emanuelvsz/localfy/hardware/case/stl/frente.stl

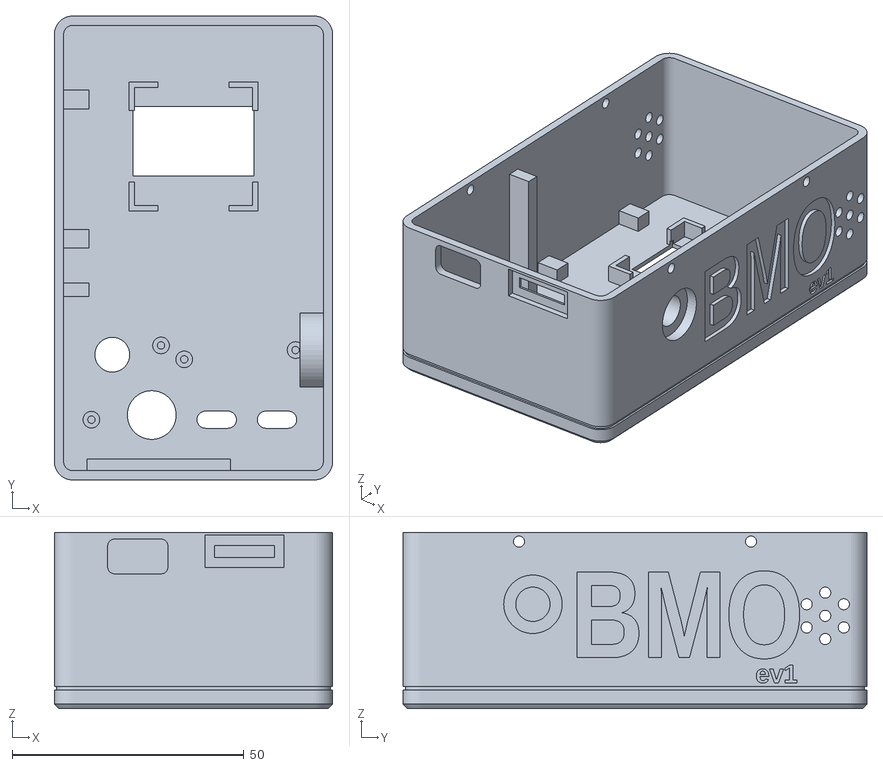
[picture p1: CAD file, 2026-10-16]
hardware/case/stl/frente.stl
60.0 x 100.0 x 38.0
