emanuelvsz/localfy/hardware/case/stl/teste_suporte.stl

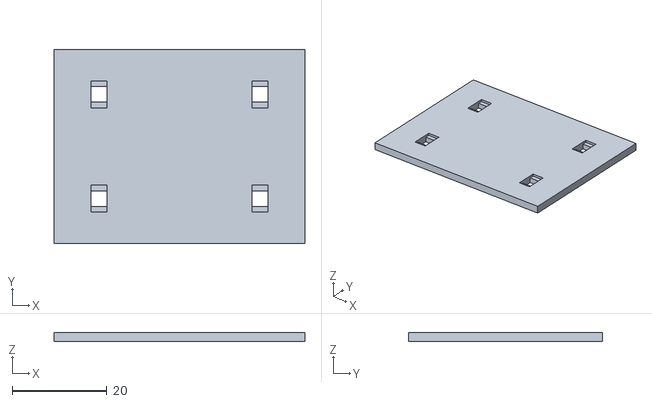
[picture p2: CAD file, 2026-10-16]
hardware/case/stl/teste_suporte.stl
53.0 x 41.0 x 2.00
