emanuelvsz/localfy/hardware/case/stl/base.stl

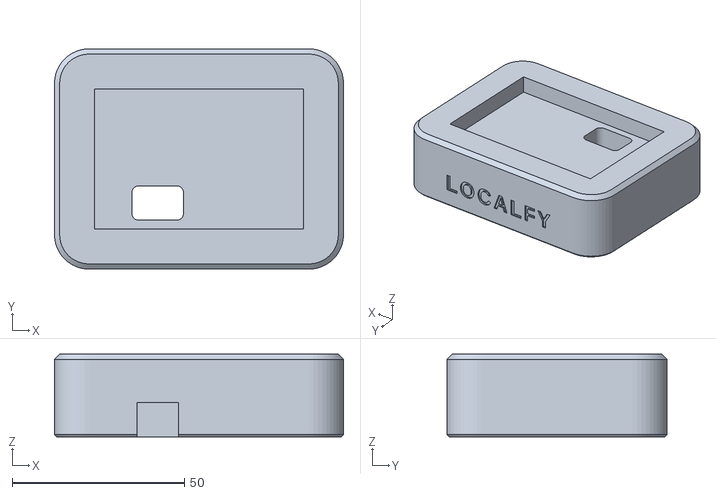
[picture p3: CAD file, 2026-10-16]
hardware/case/stl/base.stl
84.0 x 64.0 x 24.0
