emanuelvsz/localfy/hardware/case/stl/tampa.stl

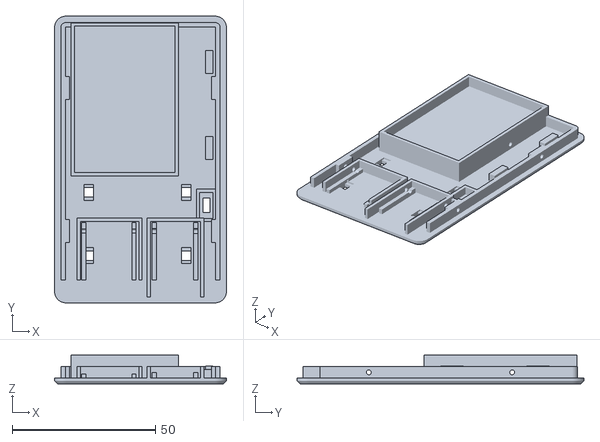
[picture p4: CAD file, 2026-10-16]
hardware/case/stl/tampa.stl
60.0 x 100.0 x 10.0
