emanuelvsz/localfy/hardware/case/stl/moldura.stl

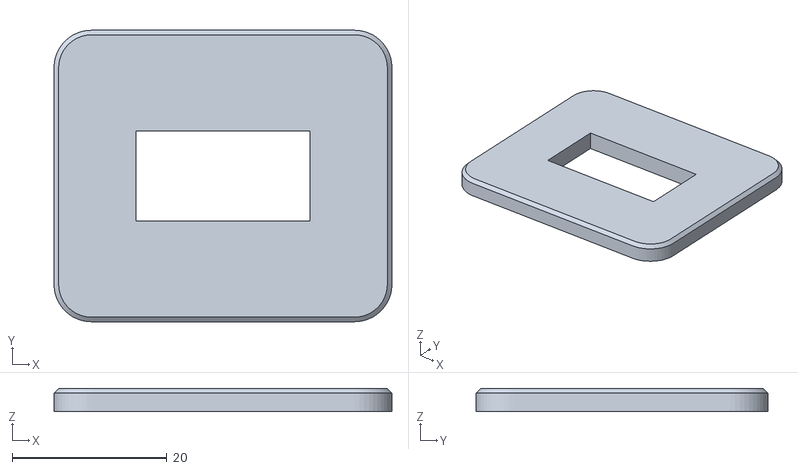
[picture p5: CAD file, 2026-10-05]
hardware/case/stl/moldura.stl
43.7 x 37.7 x 3.00
