emanuelvsz/localfy/hardware/case/stl/bolinha.stl

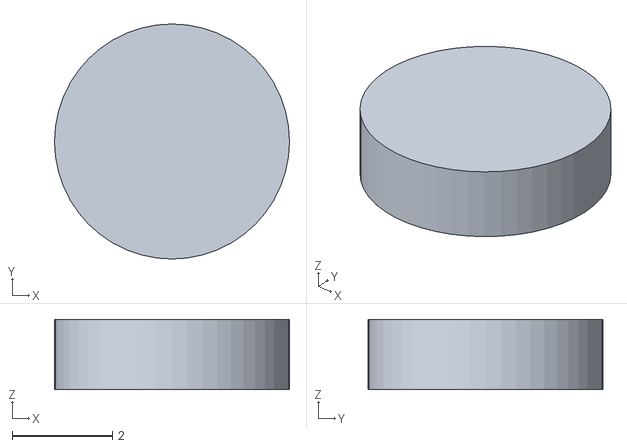
[picture p6: CAD file, 2026-10-05]
hardware/case/stl/bolinha.stl
4.70 x 4.70 x 1.40
