emanuelvsz/localfy/hardware/case/stl/cruz.stl

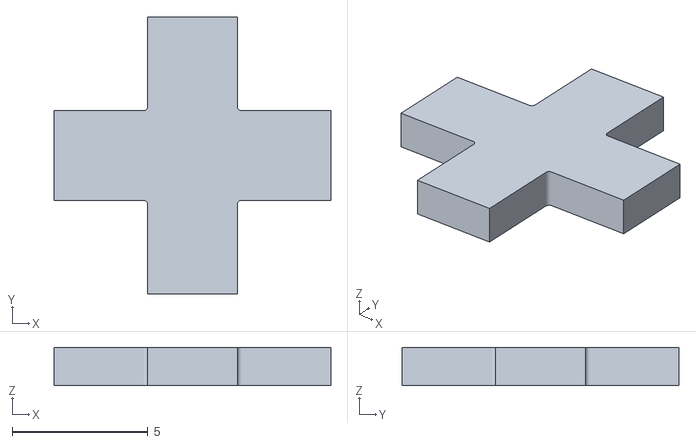
[picture p7: CAD file, 2026-10-05]
hardware/case/stl/cruz.stl
10.2 x 10.2 x 1.40
