emanuelvsz/localfy/hardware/case/stl/vermelho.stl

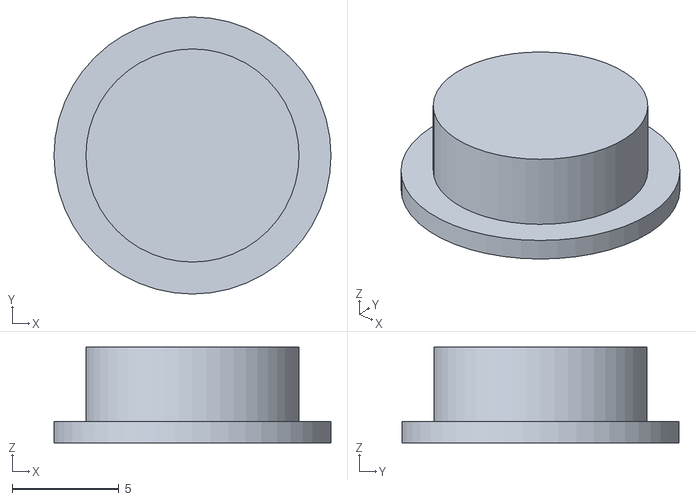
[picture p8: CAD file, 2026-10-05]
hardware/case/stl/vermelho.stl
13.0 x 13.0 x 4.50
