emanuelvsz/localfy/hardware/case/stl/fenda.stl

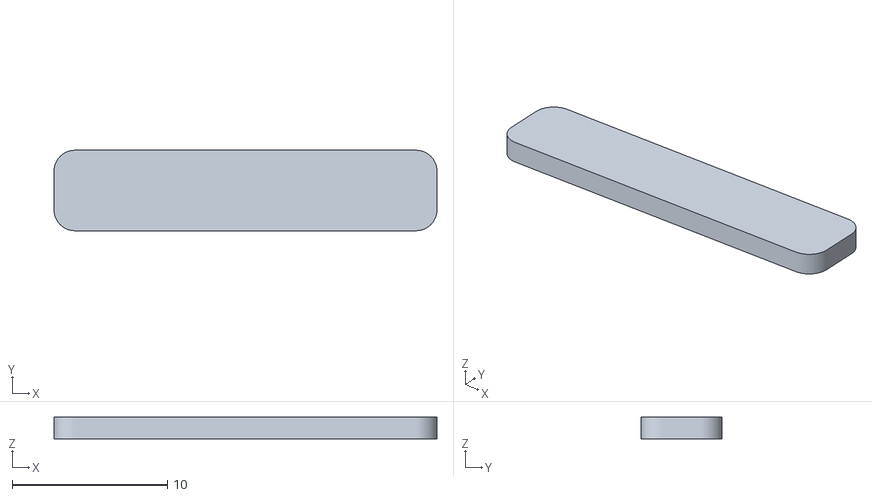
[picture p9: CAD file, 2026-10-05]
hardware/case/stl/fenda.stl
24.7 x 5.20 x 1.40
