emanuelvsz/localfy/hardware/case/stl/triangulo.stl

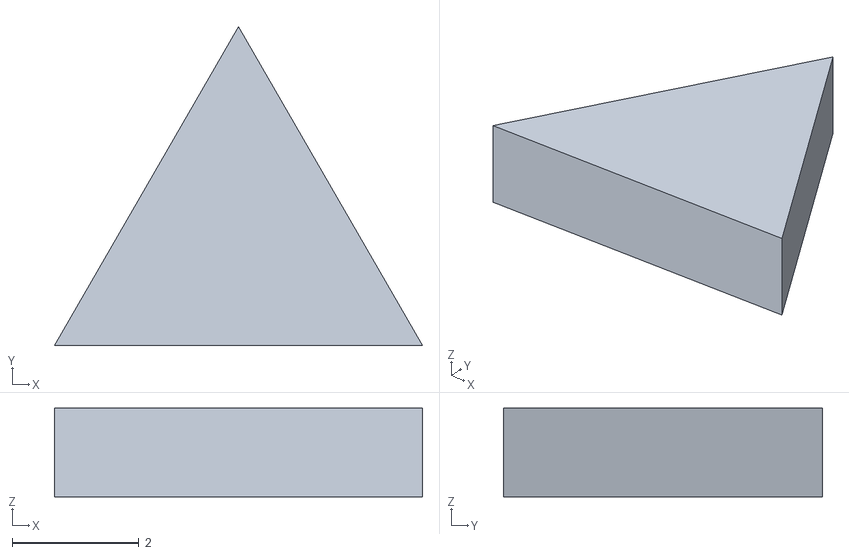
[picture p10: CAD file, 2026-10-05]
hardware/case/stl/triangulo.stl
5.81 x 5.03 x 1.40
