emanuelvsz/localfy/hardware/case/stl/verde.stl

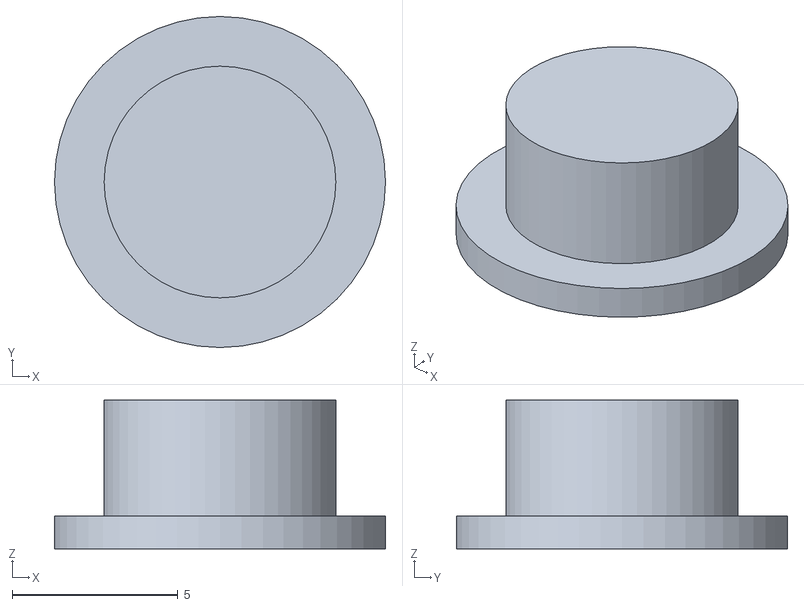
[picture p11: CAD file, 2026-10-05]
hardware/case/stl/verde.stl
10.0 x 10.0 x 4.50
