emanuelvsz/localfy/hardware/case/stl/letras.stl

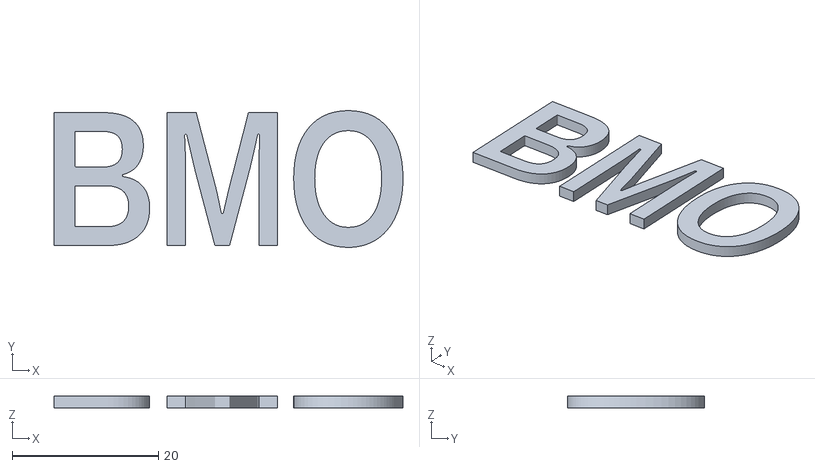
[picture p12: CAD file, 2026-10-05]
hardware/case/stl/letras.stl
47.7 x 18.7 x 1.60
