emanuelvsz/localfy/hardware/case/stl/knob.stl

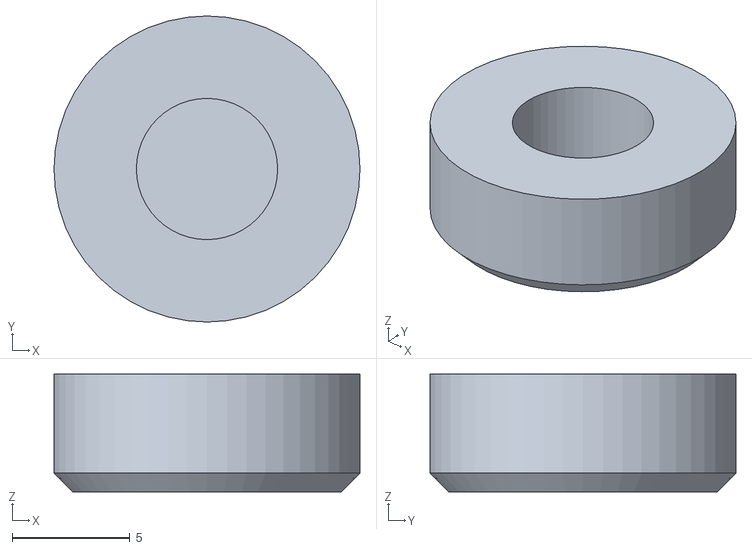
[picture p13: CAD file, 2026-10-05]
hardware/case/stl/knob.stl
13.0 x 13.0 x 5.00
