emanuelvsz/localfy/hardware/case/stl/pilula.stl

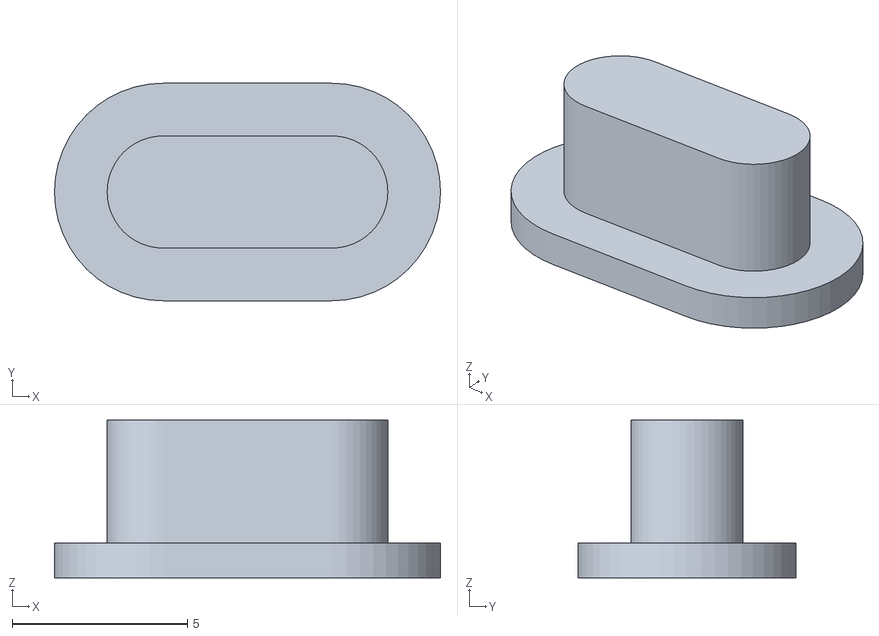
[picture p14: CAD file, 2026-10-05]
hardware/case/stl/pilula.stl
11.0 x 6.20 x 4.50
