emanuelvsz/localfy/hardware/case/stl_limites.scad

// Gerado por gerar_figuras.sh: limites de cada STL [min, max].
stl_limits = [
  ["base", [-12.00, -52.00, 0.00], [72.00, 12.00, 24.00]],
  ["bolinha", [11.65, 37.65, 0.00], [16.35, 42.35, 1.40]],
  ["cruz", [39.40, 22.90, 0.00], [49.60, 33.10, 1.40]],
  ["fenda", [26.15, 37.90, 0.00], [50.85, 43.10, 1.40]],
  ["frente", [0.00, 0.00, 0.00], [60.00, 100.00, 38.00]],
  ["knob", [53.50, -6.50, 0.00], [66.50, 6.50, 5.00]],
  ["letras", [-23.38, -9.13, 0.00], [24.32, 9.57, 1.60]],
  ["moldura", [8.15, 54.15, 0.00], [51.85, 91.85, 3.00]],
  ["pilula", [54.50, -3.10, 0.00], [65.50, 3.10, 4.50]],
  ["tampa", [0.00, 0.00, 0.00], [60.00, 100.00, 10.00]],
  ["teste_suporte", [5.00, -4.00, 0.00], [58.00, 37.00, 2.00]],
  ["triangulo", [20.10, 28.32, 0.00], [25.90, 33.35, 1.40]],
  ["verde", [55.00, -5.00, 0.00], [65.00, 5.00, 4.50]],
  ["vermelho", [53.50, -6.50, 0.00], [66.50, 6.50, 4.50]]];
