emanuelvsz/localfy/MANUAL.md

# Manual do Localfy

O Localfy é um tocador de música portátil com cara de BMO. Ele toca as músicas
do cartão de memória num fone ou numa caixa Bluetooth, sem precisar de celular
nem de internet. Pelo navegador, você envia músicas e vê as suas estatísticas.

---

## 1. Conhecendo o aparelho

### Botões

| Botão | O que faz |
|---|---|
| 🔵 **Azul esquerdo** | Volta / sobe na lista |
| 🔵 **Azul direito** | Avança / desce na lista |
| 🟢 **Verde** | Toca e pausa · escolhe · confirma |
| 🔴 **Vermelho** | Volta um nível · troca de modo |
| 🎛️ **Knob do ombro** | Volume |
| **Chave nas costas** | Liga e desliga |

**Segurar** um botão faz outras coisas:

| Segurar | O que faz |
|---|---|
| 🔵 Azul (na lista) | Pula uma página inteira; continuando a segurar, segue pulando |
| 🟢 Verde por 3 s | Modo standby (a cara do BMO) |
| 🔴 Vermelho por 3 s | Escolher outro fone ou caixa |

### Na parte de baixo
- **Entrada do cartão microSD:** onde ficam as músicas.
- **Entrada USB-C:** para carregar a bateria.

---

## 2. Ligar, desligar e carregar

- **Ligar e desligar:** pela chave nas costas. Ao ligar, a tela mostra
  "Localfy iniciando" e o modo atual.
- **Carregar:** ligue um cabo USB-C (carregador de celular ou computador).
  - **Luz vermelha** = carregando · **luz azul** = carga completa.
  - Para a bateria carregar por completo, **deixe o aparelho desligado** na
    chave enquanto carrega. Tocar enquanto carrega funciona, mas a carga não
    termina direito.
- Quando o som começar a falhar ou o aparelho reiniciar sozinho, a bateria está
  acabando: desligue e carregue.

---

## 3. Primeira vez: conectar o fone ou a caixa

1. Coloque o fone ou a caixa em **modo de pareamento** (normalmente é segurar o
   botão de Bluetooth até a luz piscar rápido).
2. No Localfy, **segure o vermelho por 3 segundos**. Aparece **"ESCOLHER
   FONE"** e, em 10 a 15 segundos, a lista de aparelhos de áudio por perto.
3. Escolha com os **azuis** e conecte no **verde**. O **vermelho** cancela.

O aparelho escolhido fica **salvo**: das próximas vezes o Localfy conecta nele
sozinho ao ligar. Se o fone desligar ou sair de alcance, o Localfy volta a
procurá-lo e reconecta quando ele aparecer.

> Na barra de cima da tela aparece o nome do aparelho conectado, ou
> "BT buscando..." enquanto ele procura.

---

## 4. Tocando música

### A tela do player
```
JBL WAVE FLEX        BT     ← aparelho conectado
Joji                        ← artista
‾‾‾‾
SLOW DANCING IN THE         ← música
DARK
> 1:12/3:29        42/177   ← tocando, tempo, posição
────────────                ← progresso
```

- **Verde** toca e pausa.
- Quando uma música termina, a próxima começa sozinha.

### Escolher uma música
1. No player, aperte um **azul**: abre a lista **na pasta que está tocando**,
   já com a música atual selecionada (esse primeiro toque só abre).
2. Ande com os **azuis**. Para ir mais rápido, **segure** um azul: ele pula de
   página em página.
3. **Verde** toca a música escolhida.

### As pastas (artistas)
As músicas ficam separadas por artista. Na lista de músicas, aperte o
**vermelho** para subir para a lista de pastas:

```
Biblioteca
─────────────────────
 Aleatorio        NAO
▐>Todas           177▌
  2Pac              2
  Ambrosia          2
─────────────────────
pag 1/29        2/115
```

- **Todas:** a biblioteca inteira, agrupada por artista.
- **Sem pasta:** músicas que ainda não estão na pasta de um artista (aparece só se houver alguma).
- **Uma pasta:** só as músicas daquele artista. O número ao lado é quantas ele tem.
- O **">"** marca a pasta que está tocando agora.

**Verde** abre a pasta. **Vermelho** volta (das músicas para as pastas, e das
pastas para o player). A lista fecha sozinha depois de 8 segundos sem mexer.

> Ao tocar uma música de dentro de uma pasta, a pasta vira a **fila**: "próxima" e
> "anterior" ficam dentro dela. Para tocar de tudo, escolha a música por **Todas**.

---

## 5. Modo aleatório

1. Abra a lista (um **azul**) e suba para as pastas (**vermelho**).
2. O primeiro item é **"Aleatorio NAO"**. Selecione e aperte o **verde**: vira
   **"SIM"**. A barra de cima do player passa a mostrar **ALE**.
3. Escolha de onde vêm as músicas e toque qualquer uma:
   - **Todas**: sorteia na biblioteca inteira;
   - **Uma pasta**: sorteia só entre as músicas daquele artista.

Para desligar, volte ao primeiro item e aperte o **verde** de novo. A escolha
fica salva, mesmo desligando o aparelho.

---

## 6. Volume

Gire o **knob do ombro**. O volume aparece por um instante na barra de cima
("Volume 45%").

> O knob controla o volume que o Localfy envia. Deixe o **volume do próprio fone
> ou caixa em 70% a 80%** e use o knob para o ajuste fino. Se o som estiver baixo
> mesmo com o knob no máximo, aumente o volume no fone ou na caixa.

---

## 7. Standby (a cara do BMO)

- **Segure o verde por 3 segundos:** a tela mostra a cara do BMO, que pisca e
  muda de expressão. A música continua como estava (tocando ou pausada).
- **Clique no verde** para voltar ao player.
- No standby, os outros botões não fazem nada; o knob continua mudando o volume.

---

## 8. Modo Web: enviar e organizar músicas pelo navegador

No modo Web o Localfy **não toca música**. É o modo de gerenciar o acervo.

### Entrar no modo Web
1. No player, aperte o **vermelho**: aparece **"Ir para o modo: WEB"**.
2. Confirme no **verde** (o vermelho cancela; a pergunta some sozinha em 10 s).
3. O aparelho reinicia, e a tela mostra:
   ```
   Rede:  Localfy
   Senha: Localfy271003!
   Abra no navegador:
   http://192.168.4.1
   ```

### Conectar pelo celular ou computador
1. Entre na rede Wi-Fi **Localfy**, com a senha **Localfy271003!**.
2. Normalmente a página abre sozinha. Se não abrir, acesse **http://192.168.4.1**.
3. O celular pode avisar que **"esta rede não tem internet"**: escolha **manter
   conectado**. A rede é só entre você e o Localfy.

### O que dá para fazer na página
- **Enviar músicas (MP3 ou WAV):** escreva o nome do artista em **"Pasta do
  artista"** e arraste os arquivos (ou toque para escolher). Elas já entram na
  pasta certa.
- **Ver e filtrar a biblioteca:** busca por nome, filtro MP3/WAV e por pasta.
- **Criar pasta:** botão **"+ Nova pasta"**.
- **Editar uma música** (ícone de lápis): artista, gênero e **pasta** (mudar a
  pasta move a música).
- **Apagar uma música** (ícone de lixeira).
- **Fila do aparelho:** escolha a pasta e ligue ou desligue o **aleatório** para
  quando voltar ao modo Bluetooth.
- **Estatísticas:** escutas por dia e por hora do mês, artistas e gêneros mais
  ouvidos, **"Salvar resumo"** (uma imagem para compartilhar) e **"Baixar CSV"**
  (o histórico completo).

> Abrir a página também acerta o relógio do Localfy com a hora do celular. É isso
> que coloca a data certa no seu histórico de escutas.

### Voltar a tocar
Aperte o **vermelho** e confirme no **verde**: o Localfy reinicia no modo
Bluetooth e reconecta no seu fone.

---

## 9. O cartão de memória

- Formatos aceitos: **MP3 e WAV**. Até **256 músicas**.
- Organização no cartão:
  ```
  music/
    Joji/
      LOVE YOU LESS.mp3
      SLOW DANCING IN THE DARK.mp3
    Radiohead/
      Creep.mp3
  localfy/          ← arquivos do sistema (não apague)
  ```
- Dá para copiar músicas direto pelo computador: crie a pasta do artista dentro
  de `music/` e coloque os arquivos nela. Músicas soltas em `music/` aparecem em
  "Sem pasta".
- **Sempre desligue o Localfy** antes de tirar ou colocar o cartão.

### Organizar automaticamente pelo computador (opcional)
Com o cartão no computador, o script `tools/organizar_pastas.py` lê o artista
de cada música e organiza tudo em pastas, com nomes padronizados:
```
python3 tools/organizar_pastas.py /media/<usuario>/<cartao>             # mostra o plano
python3 tools/organizar_pastas.py /media/<usuario>/<cartao> --aplicar   # aplica
```

---

## 10. Problemas comuns

| Problema | O que fazer |
|---|---|
| O fone não conecta | Coloque o fone em modo de pareamento e **segure o vermelho por 3 s** para escolhê-lo de novo. Confira se ele não está conectado a um celular ao mesmo tempo. |
| Conecta, mas não sai som | Aumente o volume **no fone ou na caixa** e confira o knob do Localfy. |
| Música com som estranho ou travando | Desligue e ligue a chave. Se acontecer sempre na mesma música, o arquivo pode estar com defeito. |
| "Sem cartao SD" na tela | Desligue, encaixe o cartão de novo e ligue. |
| "Biblioteca vazia" | As músicas precisam estar na pasta `music/` do cartão. |
| A rede "Localfy" não aparece | Confira se o aparelho está no modo Web (a tela mostra "Rede: Localfy"). |
| A página não abre | Acesse **http://192.168.4.1** com o celular conectado na rede Localfy. |
| Histórico sem data | Abra a página no modo Web pelo menos uma vez depois de ligar o aparelho. |
| Travou | Desligue e ligue pela chave. As músicas, o fone escolhido, a fila e o histórico ficam salvos. |

---

## 11. Cuidados

- Não deixe o aparelho no sol forte nem molhado.
- Use cabo e carregador USB-C em bom estado. Se o aparelho esquentar muito
  carregando, desconecte.
- Se a bateria inchar, pare de usar e troque.
