emanuelvsz/localfy/(commit log)

2026-09-25 Localfy V1: interface web, firmware ESP32 e modo de testes
    Tocador autonomo com SD, A2DP, OLED e controle via web.
    - index.html: SPA sem dependencias, tema escuro, player fixo,
    upload com progresso real, edicao de artista/genero e estatisticas.
    Modo de testes embutido simula o backend no navegador.
    - src/main.cpp: firmware com servidor HTTP assincrono. Historico de
    escutas em CSV append-only no proprio cartao, para o aparelho nao
    depender de nenhum PC ligado. meta.json grava via arquivo temporario
    para sobreviver a queda de energia.
    - testar.sh: abre a interface em modo de testes, sem hardware.
    Credenciais ficam em src/secrets.h, fora do versionamento.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
    [main.cpp]
2026-09-25 testar.sh: chama o navegador direto em vez de xdg-open
    O xdg-open tratava a URL como nome de arquivo e procurava por
    "index.html?mock=1" literalmente, perdendo a query string que liga
    o modo de testes. Neste ambiente ele ainda esbarra em libs quebradas
    do snap. Agora o script procura o navegador na mao.
2026-09-25 Interface em tema claro com o verde do Spotify
    Troca o fundo escuro por branco/cinza bem claro, mantendo o verde
    #1DB954 como cor de destaque.
    Sobre branco o verde puro rende apenas 2.6:1 de contraste, insuficiente
    para texto. Ele passa a ser usado so como fundo de botao (preto sobre
    verde da 8.1:1) e um tom mais escuro (--green-txt) cobre os casos em
    que o verde precisa ser lido.
    Cartoes brancos nao se separam do fundo por luminosidade como faziam no
    tema escuro, entao ganham sombra. Tags, sliders, scrollbars e mascaras
    de modal foram reconvertidos, e os botoes de play da lista ganharam
    borda: em cinza claro sobre branco eles praticamente sumiam.
    Todos os pares de cor verificados em WCAG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
2026-09-25 Corrige cantos inferiores retos nos modais
    O .modal arredondava as bordas, mas o .body tem overflow-y:auto e um
    filho com scroll nao respeita o border-radius do pai: ele desenhava os
    cantos retos por cima, deixando so o rodape quadrado.
    Adiciona overflow:hidden no .modal para recortar os filhos, sobe o raio
    para 12px e usa overscroll-behavior:contain para o scroll do modal nao
    arrastar a pagina atras dele.
2026-09-25 Bolinha do slider visivel no tema claro
    O thumb era branco, o que funcionava sobre o fundo escuro mas sumia
    depois que o fundo virou branco.
    Passa a usar a cor de texto escura, que rende 6.6:1 sobre o trecho
    verde do trilho e 13.3:1 sobre o trecho vazio -- a bolinha precisa ser
    visivel nas duas bases, conforme a posicao do slider. Um anel branco e
    uma sombra leve a separam do trilho.
2026-09-25 Estatisticas mensais com graficos e imagem de resumo
    Interface:
    - Secao do mes com navegacao entre meses, grafico de reproducoes por dia
    e distribuicao por hora do dia. SVG desenhado a mao -- uma lib de
    grafico pesaria mais que o resto da pagina, que o ESP32 serve do SD.
    - Botao "Salvar resumo" gera um cartao 1080x1920 em canvas e baixa como
    PNG: totais, grafico do mes e rankings de artista e genero.
    Firmware:
    - POST /api/stats-monthly varre o history.csv uma vez, linha a linha,
    agrupando por dia e hora do mes pedido. Recuo de meses trata virada de
    ano e fevereiro bissexto. Responde 503 sem NTP, em vez de inventar
    datas a partir de um relogio zerado.
    Modo de testes semeia 90 di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
2026-10-05 feat: implementing second version with potenciometro, new buttons and mode swtich
    [base.stl, bmo_base.scad, bmo_case.scad, bolinha.stl, cruz.stl, fenda.stl, frente.stl, knob.stl]
2026-10-16 feat: v2 do Localfy - pastas por artista, aleatorio, fones e rede propria
    Firmware
    - Bluetooth: escolha do fone pelo aparelho (segurar o vermelho), salvo na
    NVS; reconexao automatica quando o fone cai.
    - Modo Web: o ESP32 cria a propria rede "Localfy"; relogio acertado pela
    hora do navegador (POST /api/time), ja que nao ha internet/NTP.
    - Audio: pula a etiqueta ID3 (capa do album) antes do decoder; duracao
    exata pelo cabecalho Xing/Info/VBRI; conversao de taxa (48 kHz, mono)
    para 44,1 kHz estereo; volume aplicado nas amostras em vez de comandos
    AVRCP (girar o knob derrubava o fone); guarda contra pedido de audio
    sem destino.
    - Biblioteca: pastas por artista (/music/<Artista>/), n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
    [base.stl, bmo_base.scad, bmo_case.scad, figuras.scad, frente.stl, stl_limites.scad, tampa.stl, teste_suporte.stl]
2026-10-22 feat: including pcb diagram
